Peatty45113/Pulse-Oximeter-with-ESP32-MAX30102-OLED/images/finished.jpg

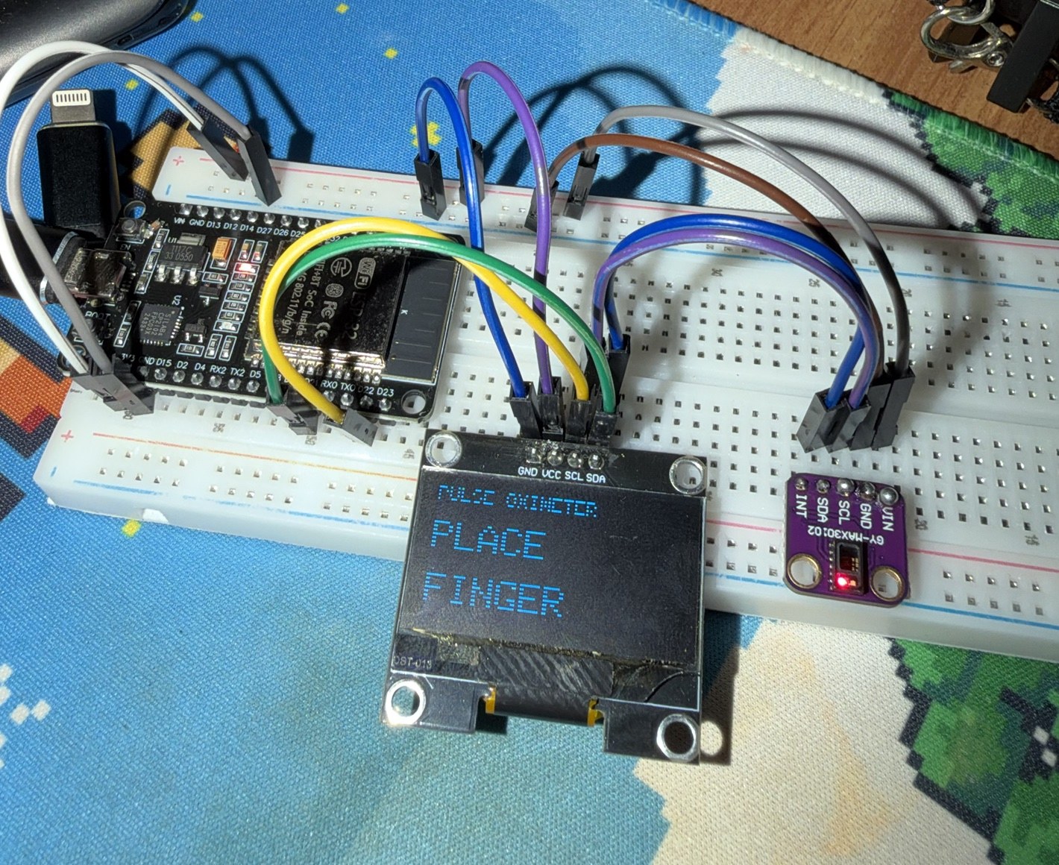
images/finished.jpg
